SarahTallack/EEE4113F_Group22/2. Sensing Submodule/Some sensing stuff.docx

Load cells and sensor amplifier

- https://www.communica.co.za/products/hkd-electronic-load-cell-20kg
- (sold out) https://www.communica.co.za/products/hkd-a-d-weighing-sensor-convert
- (RS more expensive but available) HX711 (https://za.rs-online.com/web/p/sensor-development-tools/2493961)
