SarahTallack/EEE4113F_Group22/1. Power Submodule/Power Budget.xlsx

Power Budget (Worst Case Scenario)
Component | Typ. Voltage | Max Current (mA) | Min Power (W) | Typical Power (W) | Max Power (mW) |  | Source
Temp/Humidity Sensor (On Board) | 3.3 | 0.6 |  |  | 1.98
Raspberry Pi Zero W | 5 | 370 |  |  | 1850 |  | https://www.tomshardware.com/reviews/raspberry-pi-zero-2-w-review
ESP32 S | 5 | 240 |  |  | 1200 |  | https://www.tomshardware.com/reviews/raspberry-pi-zero-2-w-review
HX711 Amplifier | 5 | 1.7 |  |  | 8.5
Power Budget (Various Operating States)
Component | Typ. Voltage | Mode of Operation | Typ. Current (mA) | Max Current Draw (mA) | Typical Power (mW) | Max Power (mW)
Temp/Humidity Sensor (On Board) | 3.3 | Measuring | 0.6 | 1.5 | 1.98 | 4.95
 |  | Idle State (Periodic Capture Mode) | ~ | 0.045 | ~ | 0.1485
Raspberry Pi Zero W | 5 | Reading sensor data and storing it (BT/WiFi off)
 |  | Turn WiFi on and transmit sensor data
 |  | Idle State | 120 |  | 600
ESP32 S | 5 | Reading sensor data and storing it
 |  | Turn WiFi on and transmit sensor data
 |  | Sleep Mode
HX711 Amplifier | 5 | Sleep Mode | 0.001 |  | 0.005 |  | From Communica Website
 |  | Weighing bird | 1.7 |  | 8.5
Power Consumption using Pi for 12hrs
Just Pi | 1.85 | W
For 12hrs | 22.2 | W | this means | 22.2 | Wh | or | 4.44 | Ah
Power Consumption using ESP32 for 12hrs
Just ESP32 | 1.2 | W
For 12hrs | 14.4 | W | this means | 14.4 | Wh | or | 2.88 | Ah
 |  |  |  |  |  |  | 2880 | mAh
Power Consumption using ESP32 for 12hrs
Sensors + amplifier | 0.01048 | W
For 12hrs | 0.12576 | W
Sensor circuitry power draw is negligible at this point, just use microcontroller values to determine system requirements
The ESP32 uses | 0.6486486486 | the amount of power when compared to the raspberry pi
However, this isnt based off of actual measurements, rather values found online. Could very well be lower. Some sites say max current comparable to that of the ESP32, however no sleep mode.
http://raspi.tv/2017/how-much-power-does-pi-zero-w-use
