SarahTallack/EEE4113F_Group22/1. Power Submodule/Group22_Power/Group22_Power.kicad_pcb

## KiCad design 1. Power Submodule/Group22_Power/Group22_Power.kicad_pcb (2023-05-07)

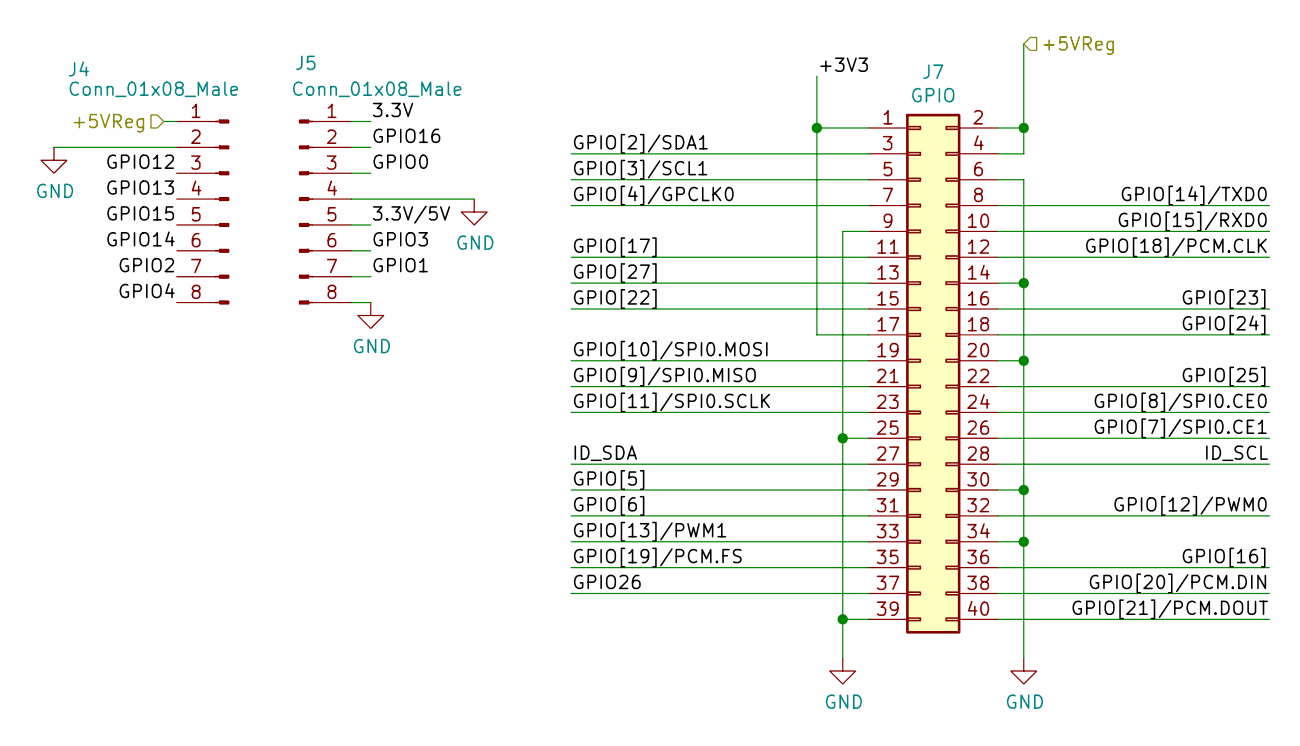
[picture p1: schematic Microcontrollers.kicad_sch]

Parts:
J4, J5: Conn_01x08_Male; PinSocket_1x08_P2.54mm_Vertical
J7: GPIO; PinSocket_2x20_P2.54mm_Vertical

Connections:
/Microcontrollers/3.3V: J5.1
/Microcontrollers/3.3V/5V: J5.5
/Microcontrollers/+3V3: J7.1, J7.17
/Microcontrollers/+5VReg: J4.1, J7.2, J7.4; also elsewhere on the board
/Microcontrollers/GPIO0: J5.3
/Microcontrollers/GPIO1: J5.7
/Microcontrollers/GPIO2: J4.7
/Microcontrollers/GPIO3: J5.6
/Microcontrollers/GPIO4: J4.8
/Microcontrollers/GPIO12: J4.3
/Microcontrollers/GPIO13: J4.4
/Microcontrollers/GPIO14: J4.6
/Microcontrollers/GPIO15: J4.5
/Microcontrollers/GPIO16: J5.2
/Microcontrollers/GPIO26: J7.37
/Microcontrollers/GPIO[2]/SDA1: J7.3
/Microcontrollers/GPIO[3]/SCL1: J7.5
/Microcontrollers/GPIO[4]/GPCLK0: J7.7
/Microcontrollers/GPIO[5]: J7.29
/Microcontrollers/GPIO[6]: J7.31
/Microcontrollers/GPIO[7]/SPI0.CE1: J7.26
/Microcontrollers/GPIO[8]/SPI0.CE0: J7.24
/Microcontrollers/GPIO[9]/SPI0.MISO: J7.21
/Microcontrollers/GPIO[10]/SPI0.MOSI: J7.19
/Microcontrollers/GPIO[11]/SPI0.SCLK: J7.23
/Microcontrollers/GPIO[12]/PWM0: J7.32
/Microcontrollers/GPIO[13]/PWM1: J7.33
/Microcontrollers/GPIO[14]/TXD0: J7.8
/Microcontrollers/GPIO[15]/RXD0: J7.10
/Microcontrollers/GPIO[16]: J7.36
/Microcontrollers/GPIO[17]: J7.11
/Microcontrollers/GPIO[18]/PCM.CLK: J7.12
/Microcontrollers/GPIO[19]/PCM.FS: J7.35
/Microcontrollers/GPIO[20]/PCM.DIN: J7.38
/Microcontrollers/GPIO[21]/PCM.DOUT: J7.40
/Microcontrollers/GPIO[22]: J7.15
/Microcontrollers/GPIO[23]: J7.16
/Microcontrollers/GPIO[24]: J7.18
/Microcontrollers/GPIO[25]: J7.22
/Microcontrollers/GPIO[27]: J7.13
/Microcontrollers/ID_SCL: J7.28
/Microcontrollers/ID_SDA: J7.27
GND: J4.2, J5.4, J5.8, J7.6, J7.9, J7.14, J7.20, J7.25, J7.30, J7.34, J7.39; also elsewhere on the board

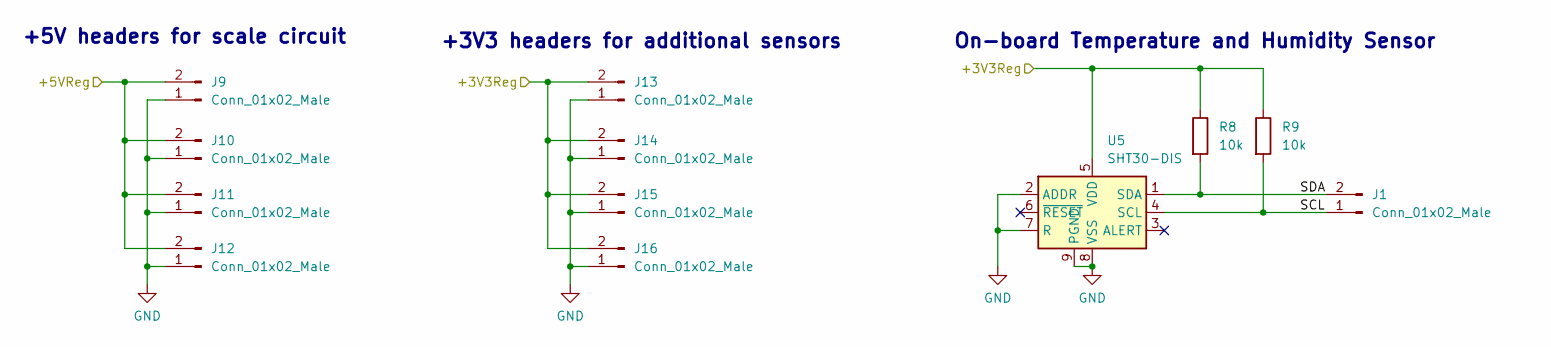
[picture p2: schematic Sensors.kicad_sch]

Parts:
J1, J9, J10, J11, J12, J13, J14, J15, J16: Conn_01x02_Male; PinHeader_1x02_P2.54mm_Vertical
R8, R9: 10k; R_0402_1005Metric; LCSC C25744
U5: SHT30-DIS; Sensirion_DFN-8-1EP_2.5x2.5mm_P0.5mm_EP1.1x1.7mm; LCSC C2687423

Connections:
/Microcontrollers/+5VReg: J9.2, J10.2, J11.2, J12.2; also elsewhere on the board
/Sensors/+3V3Reg: J13.2, J14.2, J15.2, J16.2, R8.1, R9.1, U5.5 (VDD); also elsewhere on the board
/Sensors/SCL: J1.1, R9.2, U5.4 (SCL)
/Sensors/SDA: J1.2, R8.2, U5.1 (SDA)
GND: J9.1, J10.1, J11.1, J12.1, J13.1, J14.1, J15.1, J16.1, U5.2 (ADDR), U5.7 (R), U5.8 (VSS), U5.9 (PGND); also elsewhere on the board

Notes on the sheet:
On-board Temperature and Humidity Sensor
+3V3 headers for additional sensors
+5V headers for scale circuit

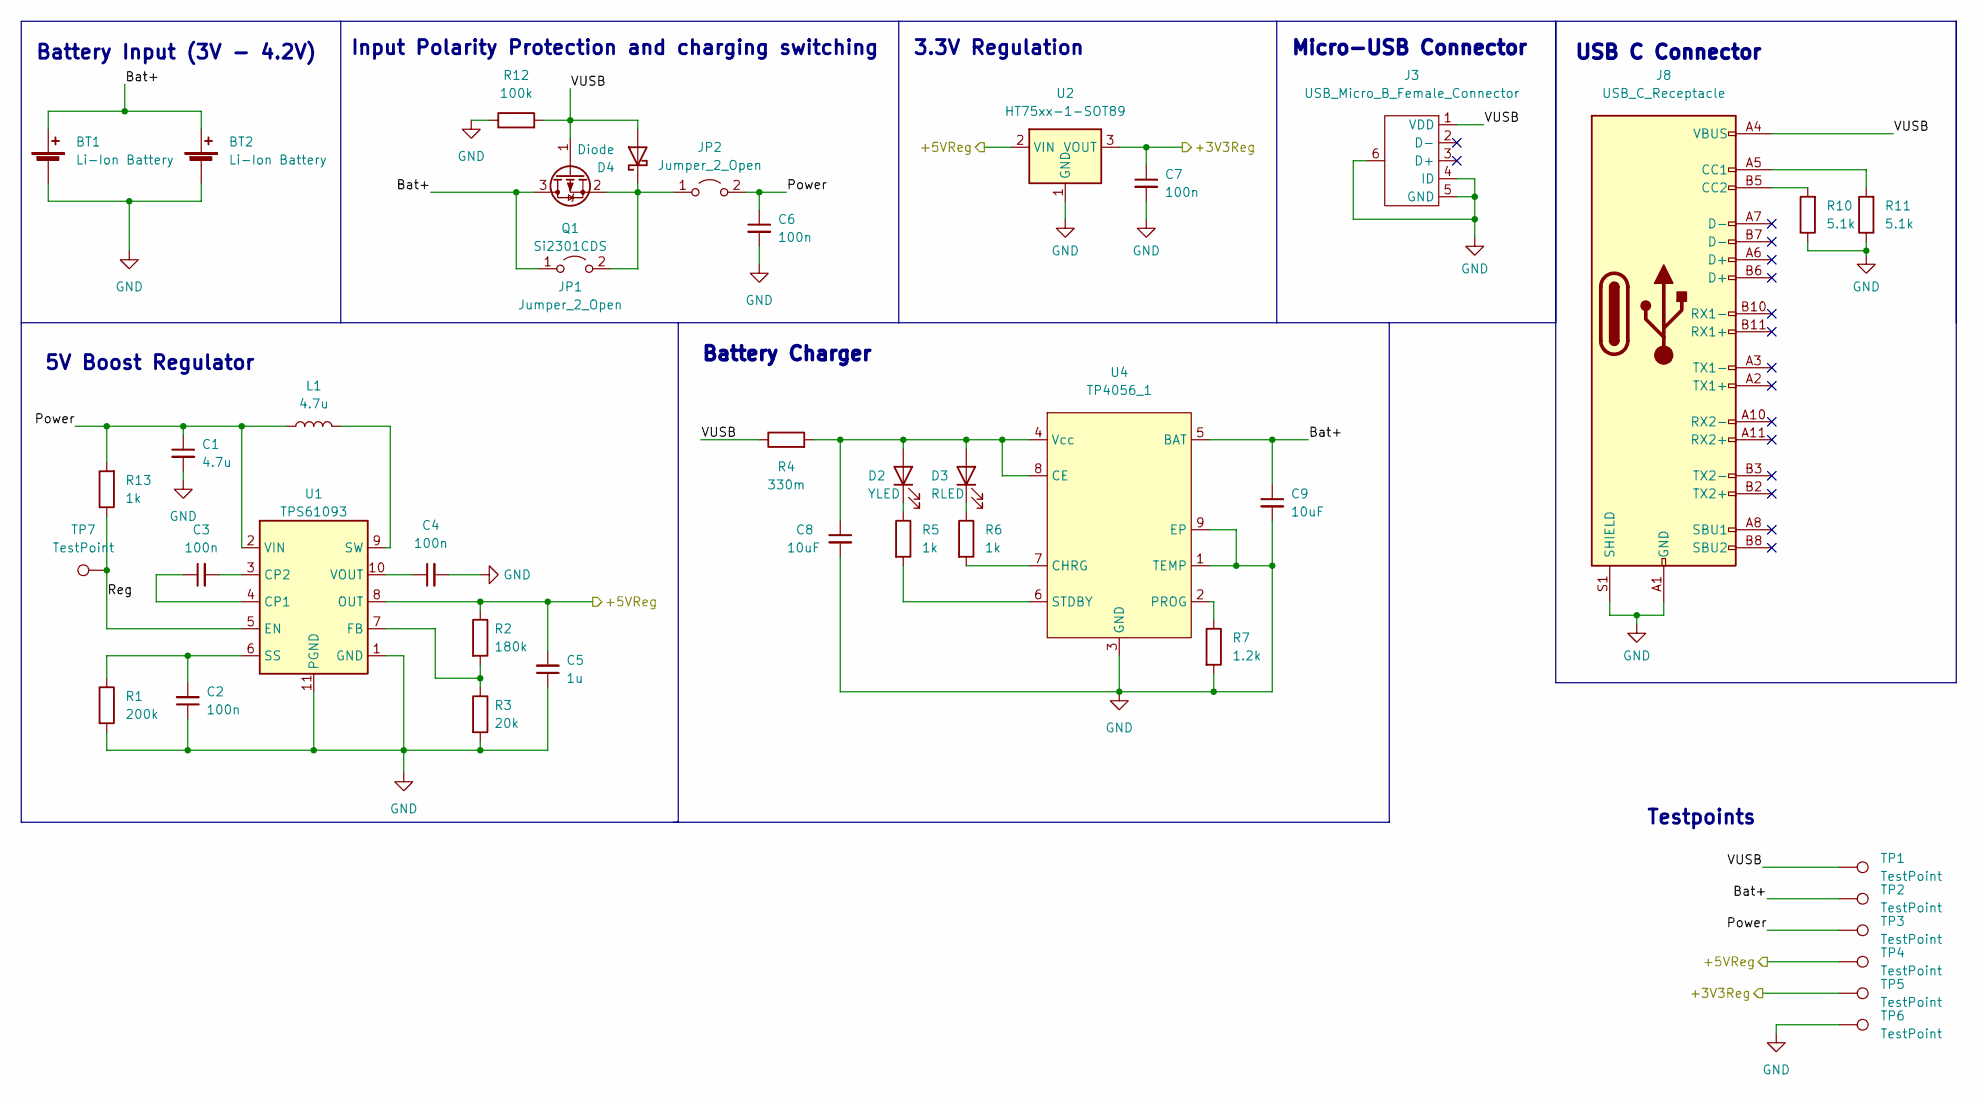
[picture p3: schematic VoltageSupply.kicad_sch]

Parts:
BT1, BT2: Li-Ion Battery; BatteryHolder_Keystone_1042_1x18650
C1: 4.7u; C_0805_2012Metric; LCSC C1779
C2, C3, C4, C6, C7: 100n; C_0603_1608Metric; LCSC C49678
C5: 1u; C_0805_2012Metric; LCSC C28323
C8, C9: 10uF; C_0402_1005Metric; LCSC C15525
D2: YLED; LED_0805_2012Metric; LCSC C2296
D3: RLED; LED_0603_1608Metric; LCSC C2286
D4: Diode; D_SOD-123; LCSC C8598
J3: USB_Micro_B_Female_Connector; C404969_Micro_USB; LCSC C404969
J8: USB_C_Receptacle; USB-TYPE-C-TH_USB-306A-B-SU; LCSC C309339
JP1, JP2: Jumper_2_Open; SolderJumper-2_P1.3mm_Open_RoundedPad1.0x1.5mm
L1: 4.7u; IND-SMD_L4.0-W4.0; LCSC C206275
Q1: Si2301CDS; SOT-23; LCSC C10487
R1: 200k; R_0805_2012Metric; LCSC C17539
R2: 180k; R_0603_1608Metric; LCSC C22827
R3: 20k; R_0603_1608Metric; LCSC C4184
R4: 330m; R_0805_2012Metric; LCSC C52548
R5, R6, R13: 1k; R_0603_1608Metric; LCSC C21190
R7: 1.2k; R_0603_1608Metric; LCSC C22765
R10, R11: 5.1k; R_0805_2012Metric; LCSC C27834
R12: 100k; R_0402_1005Metric; LCSC C25741
TP1, TP2, TP3, TP4, TP5, TP6, TP7: TestPoint; TestPoint_Pad_D2.0mm
U1: TPS61093; WSON-10-1EP_2.5x2.5mm_P0.5mm_EP1.2x2mm; LCSC C60707
U2: HT75xx-1-SOT89; SOT-89-3; LCSC C14289
U4: TP4056_1; HSOP-8-1EP_3.9x4.9mm_P1.27mm_EP2.3x2.3mm; LCSC C16581

Connections:
/Microcontrollers/+5VReg: C5.2, R2.1, TP4.1, U1.8 (OUT), U2.2 (VIN); also elsewhere on the board
/Sensors/+3V3Reg: C7.1, TP5.1, U2.3 (VOUT); also elsewhere on the board
/VoltageSupply/Bat+: BT1.1 (+), BT2.1 (+), C9.1, JP1.1 (A), Q1.3 (D), TP2.1, U4.5 (BAT)
/VoltageSupply/Power: C1.1, C6.1, JP2.2 (B), L1.1, R13.2, TP3.1, U1.2 (VIN)
/VoltageSupply/Reg: R13.1, TP7.1, U1.5 (EN)
/VoltageSupply/VUSB: D4.2 (A), J3.1 (VDD), J8.A4 (VBUS), J8.A9 (VBUS), J8.B4 (VBUS), J8.B9 (VBUS), Q1.1 (G), R4.1, R12.2, TP1.1
GND: BT1.2 (-), BT2.2 (-), C1.2, C2.1, C4.2, C5.1, C6.2, C7.2, C8.2, C9.2, J3.4 (ID), J3.5 (GND), J3.6, J8.A1 (GND), J8.A12 (GND), J8.B1 (GND), J8.B12 (GND), J8.S1 (SHIELD), R1.2, R3.2, R7.2, R10.1, R11.1, R12.1, TP6.1, U1.1 (GND), U1.11 (PGND), U2.1 (GND), U4.1 (TEMP), U4.3 (GND), U4.9 (EP); also elsewhere on the board
unnamed: C2.2, R1.1, U1.6 (SS)
unnamed: C3.1, U1.4 (CP1)
unnamed: C3.2, U1.3 (CP2)
unnamed: C4.1, U1.10 (VOUT)
unnamed: C8.1, D2.2 (A), D3.2 (A), R4.2, U4.4 (Vcc), U4.8 (CE)
unnamed: D2.1 (K), R5.1
unnamed: D3.1 (K), R6.1
unnamed: D4.1 (K), JP1.2 (B), JP2.1 (A), Q1.2 (S)
unnamed: J8.A5 (CC1), R11.2
unnamed: J8.B5 (CC2), R10.2
unnamed: L1.2, U1.9 (SW)
unnamed: R2.2, R3.1, U1.7 (FB)
unnamed: R5.2, U4.6 (STDBY)
unnamed: R6.2, U4.7 (CHRG)
unnamed: R7.1, U4.2 (PROG)

Notes on the sheet:
3.3V Regulation
Battery Input (3V - 4.2V)
Micro-USB Connector
5V Boost Regulator
Testpoints
Battery Charger
Input Polarity Protection and charging switching
USB C Connector

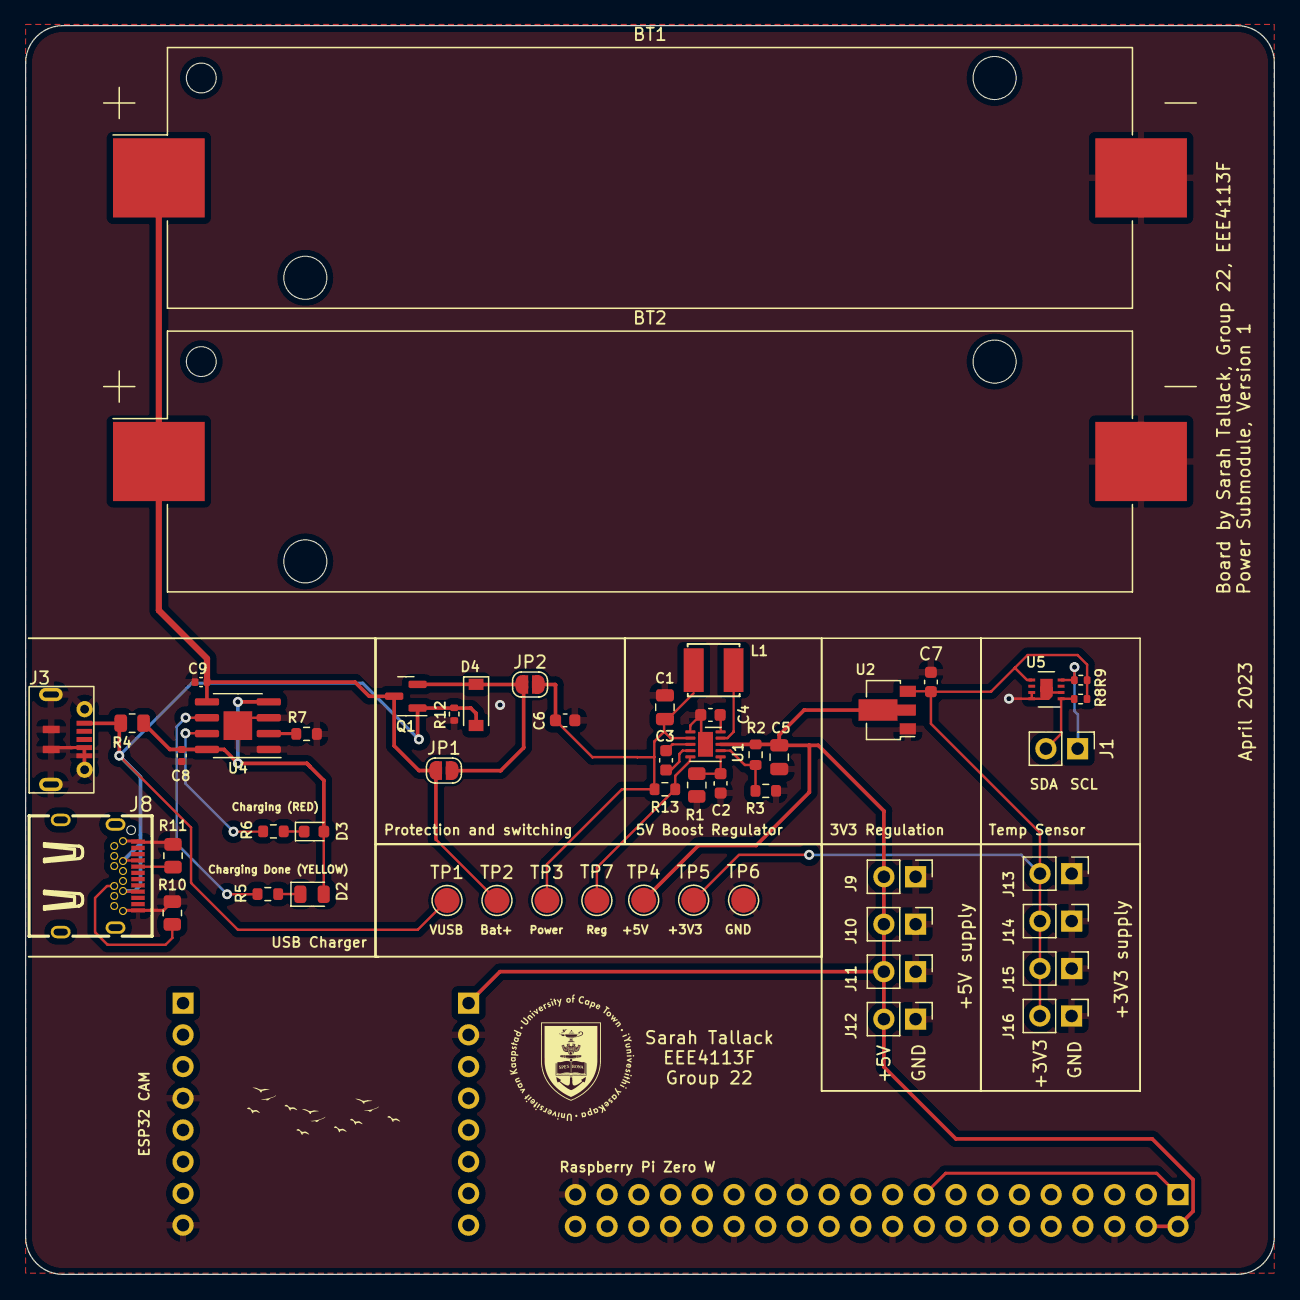
[picture p4: board Group22_Power.kicad_pcb from above]

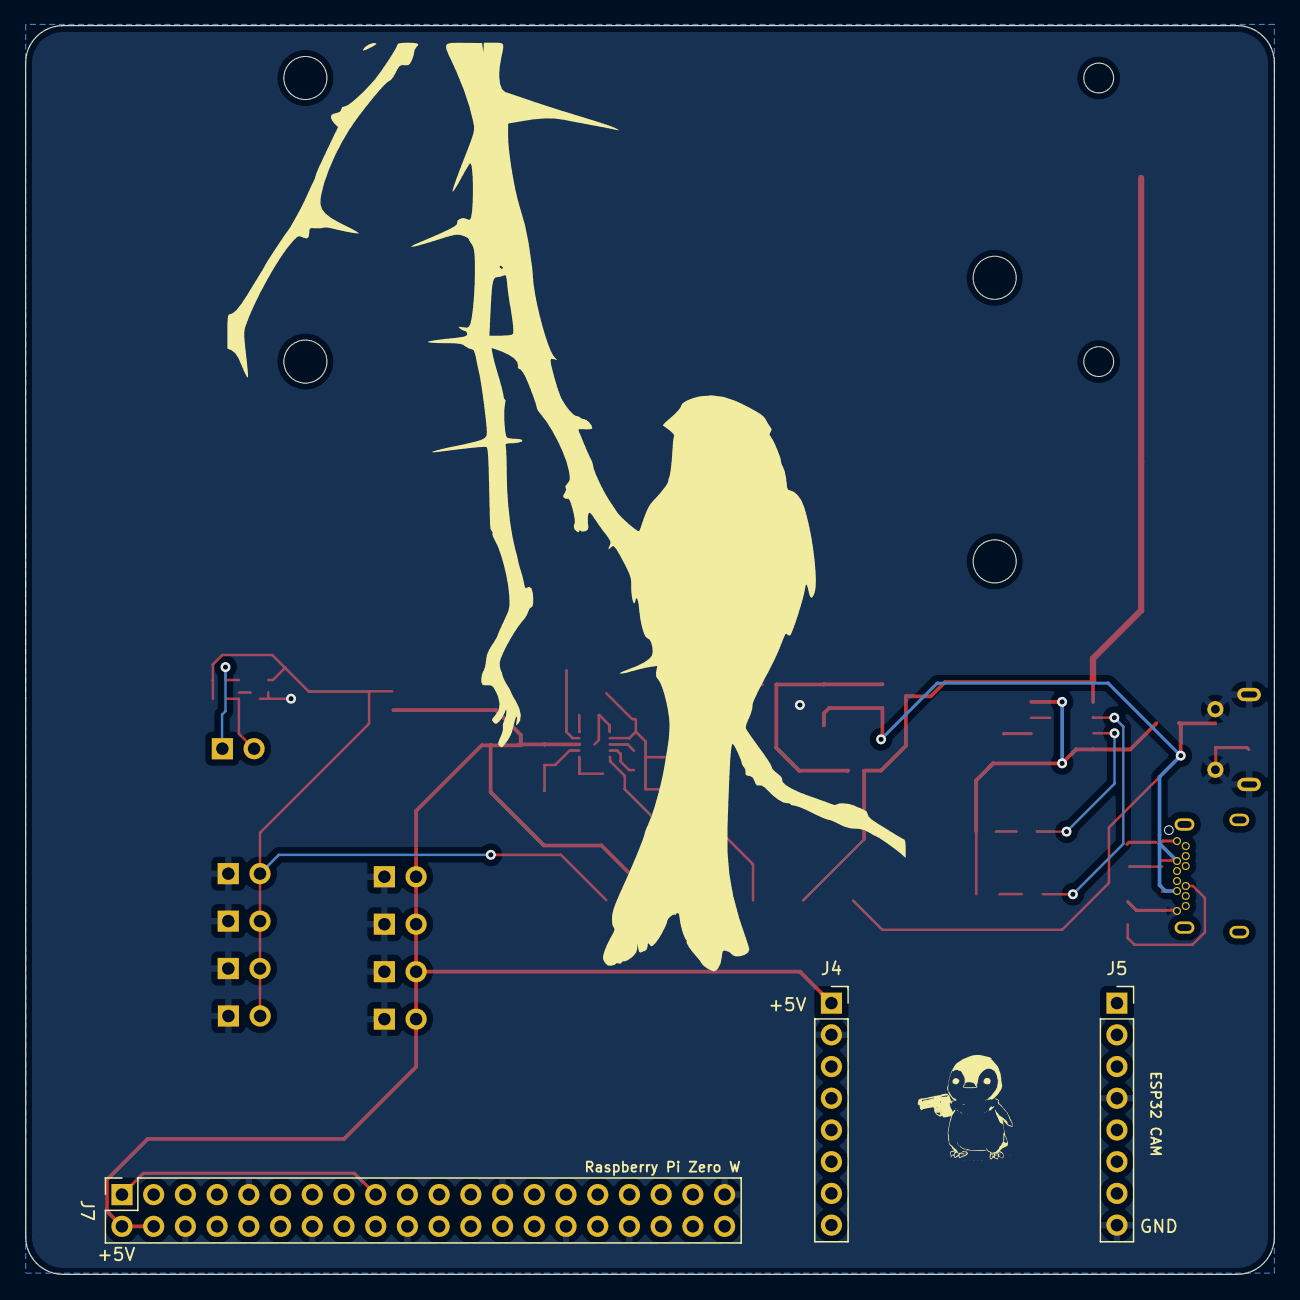
[picture p5: board Group22_Power.kicad_pcb from below]

Board: 2 copper layers, 100.0 x 100.0 mm, 56 parts (3 on the bottom side), 25 nets.
