SarahTallack/EEE4113F_Group22/(commit log)

2023-04-16 power pcb
    [Group22_Power.kicad_sch, Sensors.kicad_sch, VoltageSupply.kicad_sch]
2023-04-19 pcb done
    [Group22_Power.kicad_pcb]
2023-05-21 Power Submodule
